cmydlarz/sonyc-mk1-microphone/microphone-board/images/back_front.jpg

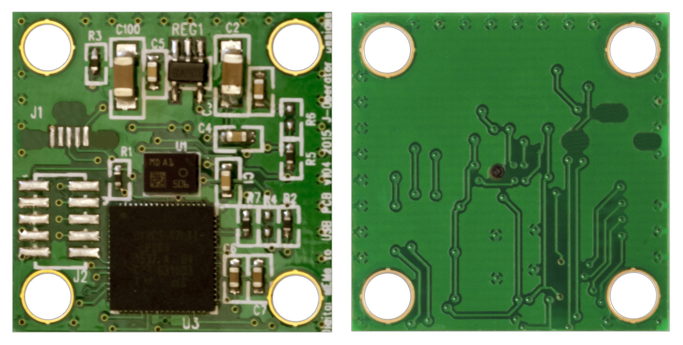
microphone-board/images/back_front.jpg
