cmydlarz/sonyc-mk1-microphone/microphone-board/images/MP34DB01.png

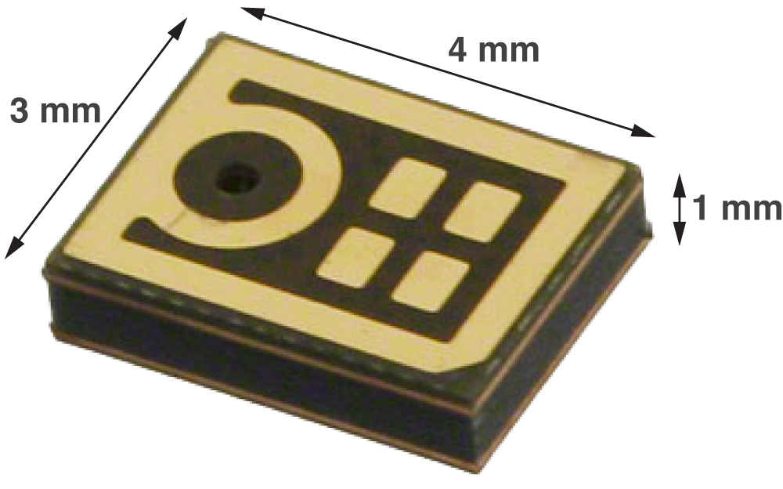
microphone-board/images/MP34DB01.png
