cmydlarz/sonyc-mk1-microphone/microphone-board/images/psoc5_board_scan.png

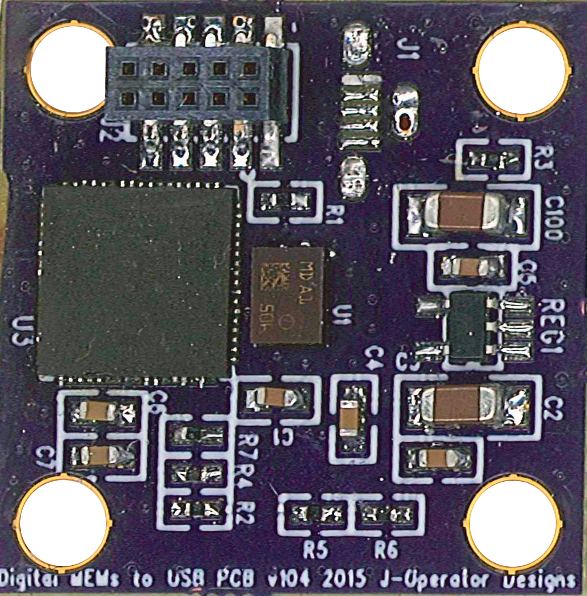
microphone-board/images/psoc5_board_scan.png
