cmydlarz/sonyc-mk1-microphone/microphone-board/images/top-layer.jpg

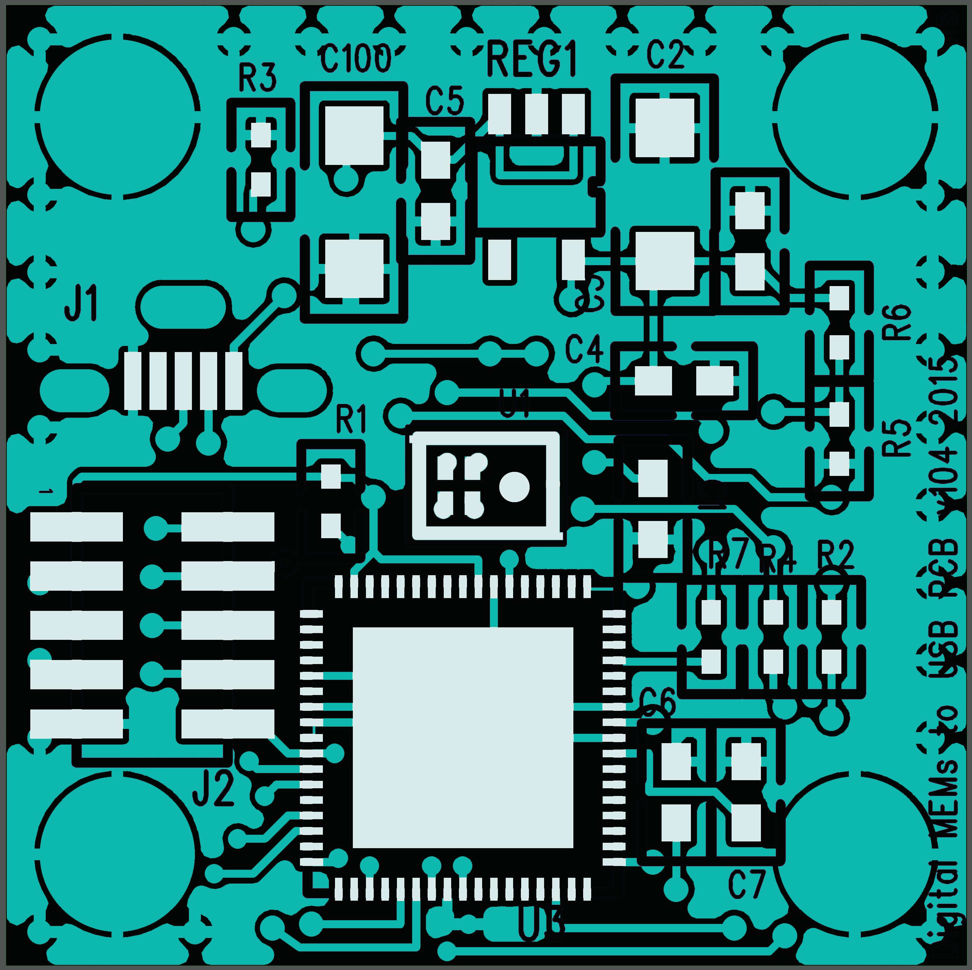
microphone-board/images/top-layer.jpg
