cmydlarz/sonyc-mk1-microphone/microphone-cal/cal-mount_2021-Aug-09_09-26-31PM-000_CustomizedView19559447086.png

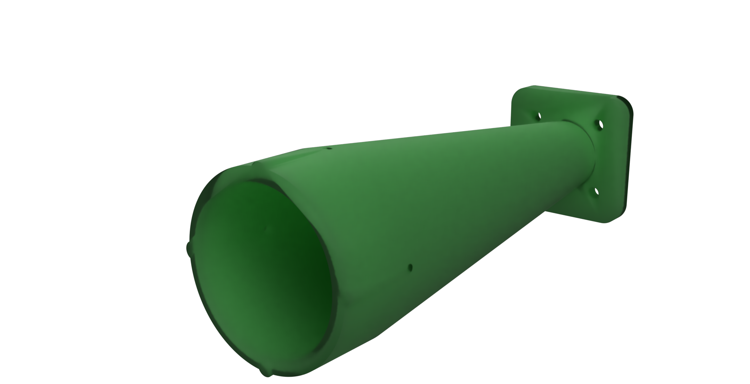
microphone-cal/cal-mount_2021-Aug-09_09-26-31PM-000_CustomizedView19559447086.png
