cmydlarz/sonyc-mk1-microphone/microphone-mount/mic_mount_v2-simple_small_shifted.png

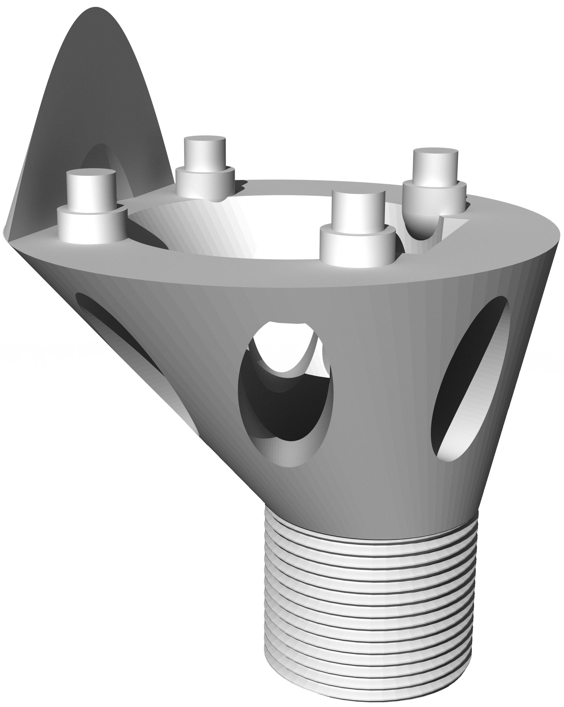
microphone-mount/mic_mount_v2-simple_small_shifted.png
