cmydlarz/sonyc-mk1-microphone/microphone-board/digital-MEMs-USB-v105.pdf

6 | 5 | 4 | 3 | 2 | 1

D

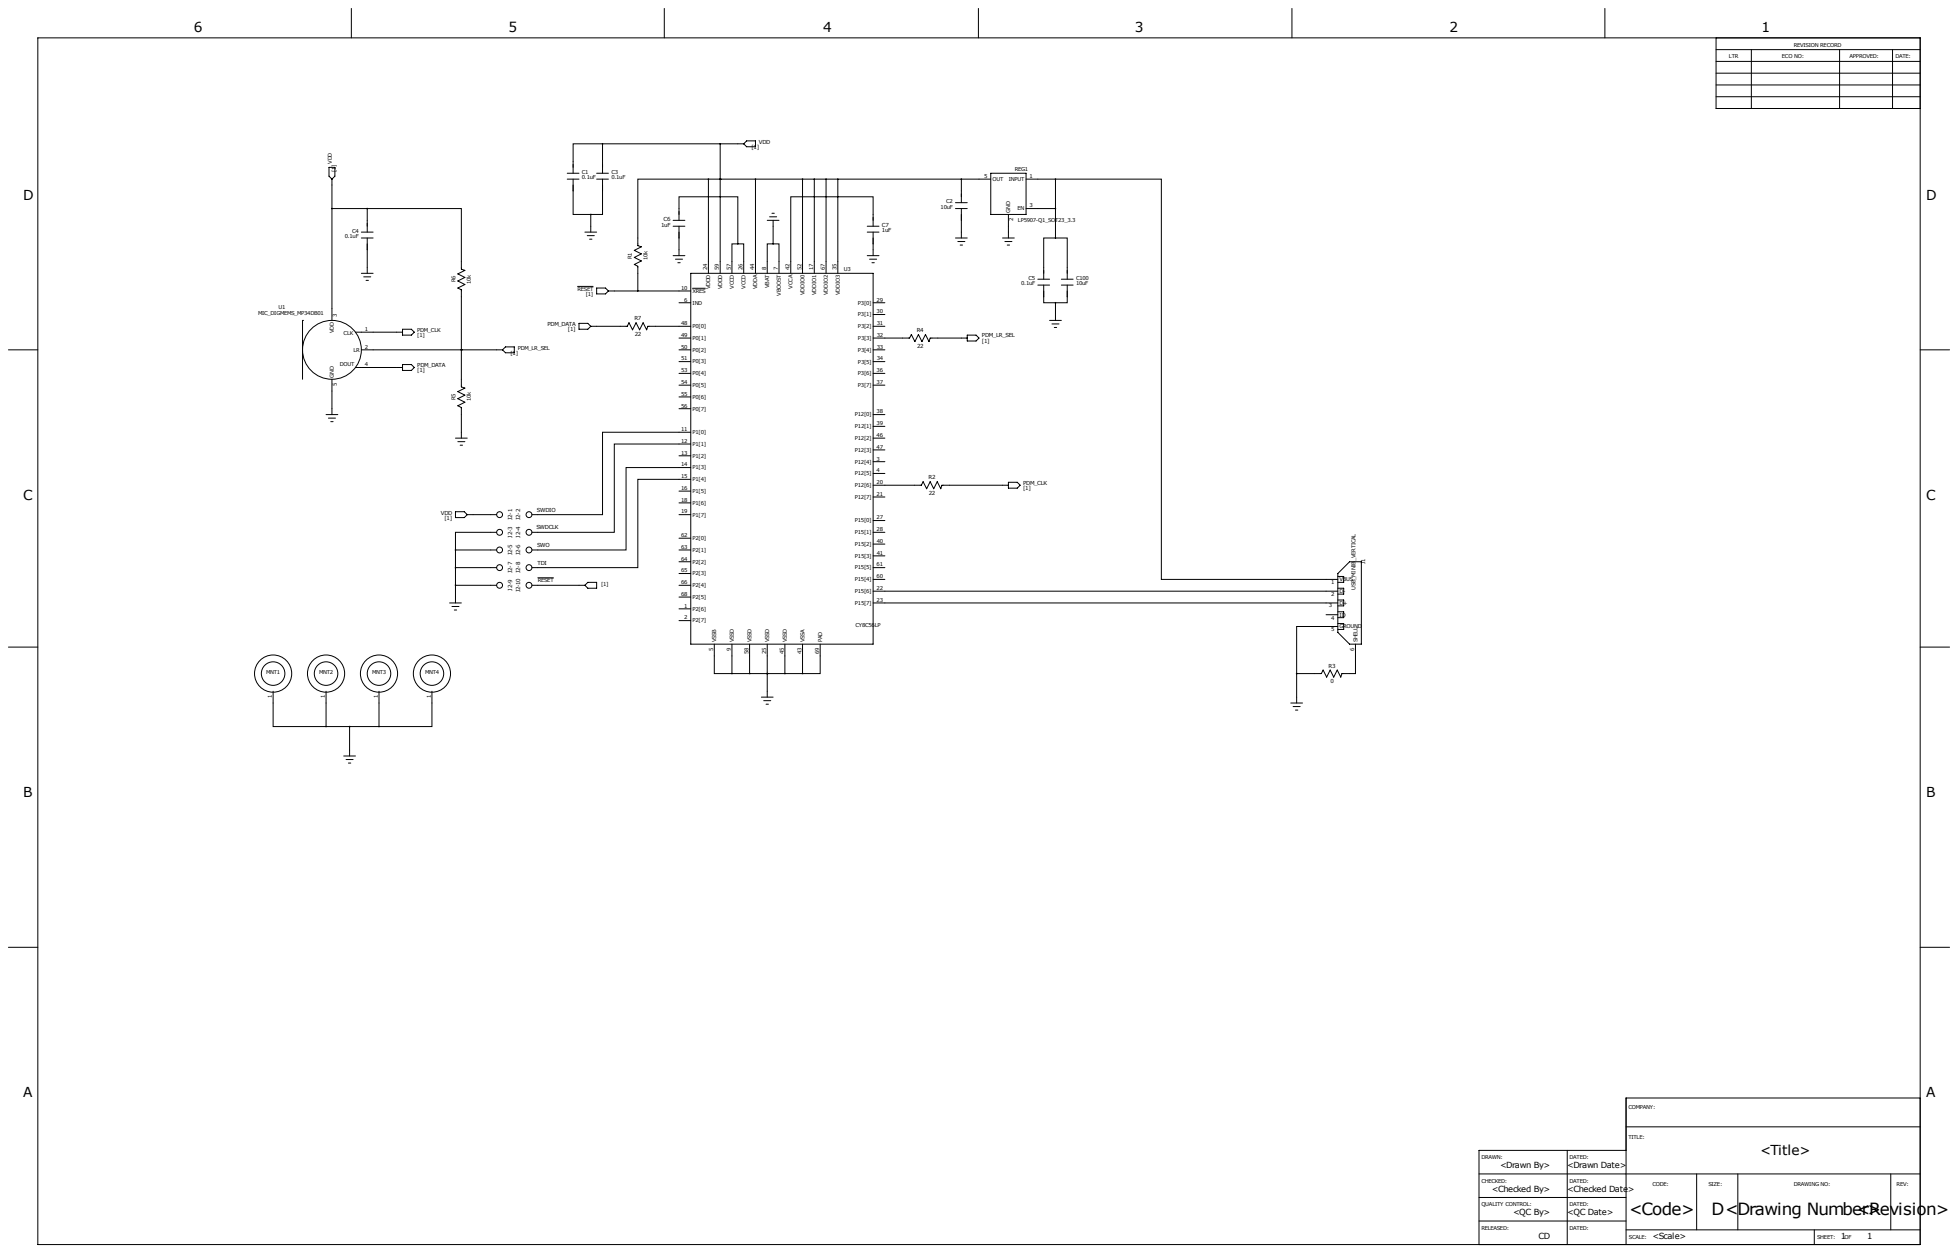
[picture p12: page 1]

VDD | REVISION RECORD

LTR | ECO NO: | APPROVED: | DATE:

DRAWN: <Drawn By> | DATED: <Drawn Date>

CHECKED: <Checked By> | DATED: <Checked Date> | CODE: <Code> | SIZE: D<Drawing Number> | DRAWING NO: | REV:

QUALITY CONTROL: <QC By> | <QC Date> DATED:

RELEASED: CD | DATED:

SCALE: <Scale> | SHEET: 1 OF 1
