cmydlarz/sonyc-mk1-microphone/microphone-board/pcb_dims.pdf

ø3.5

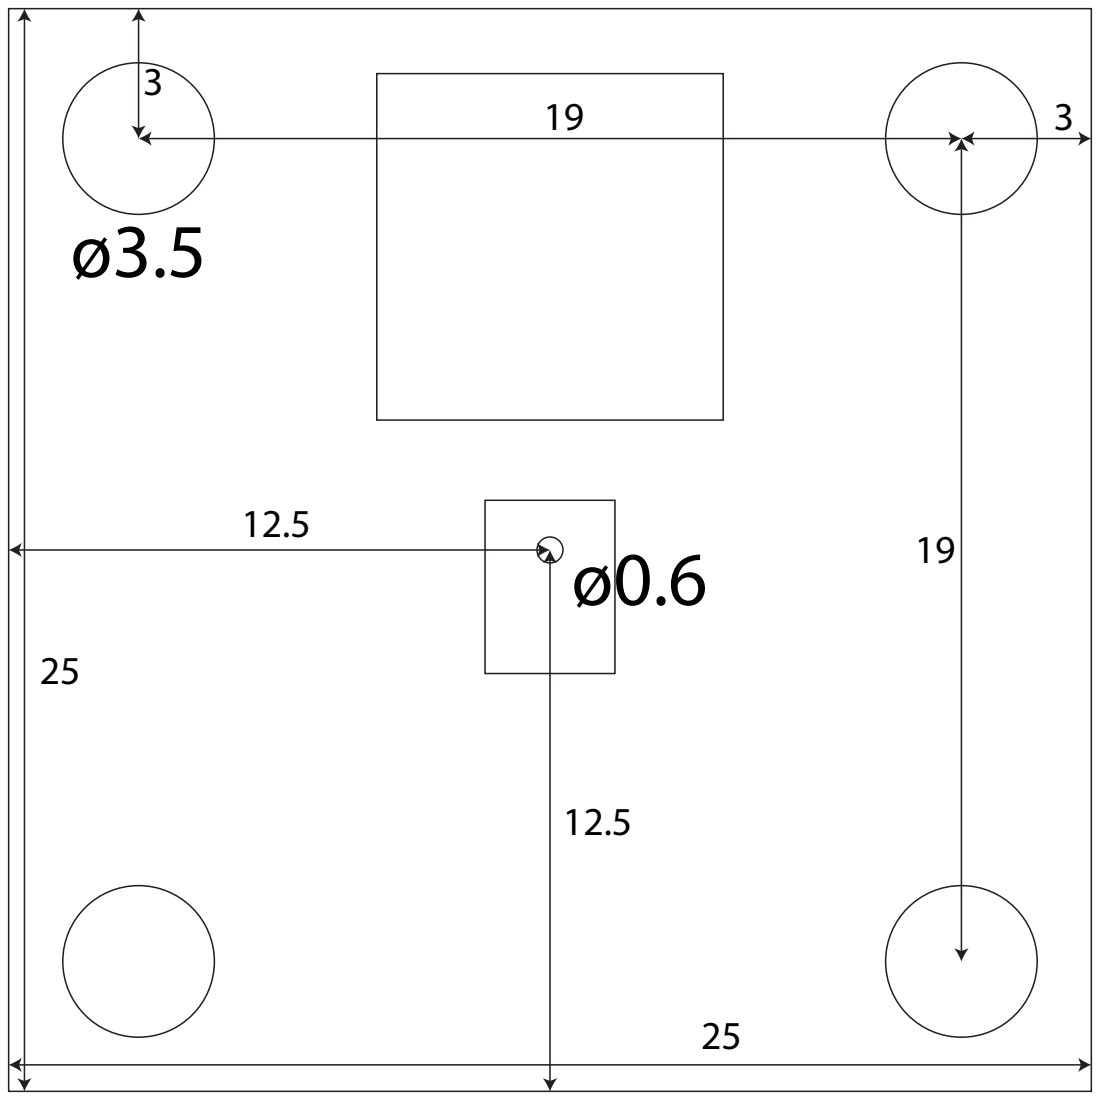
[picture p13: page 1]
