cmydlarz/sonyc-mk1-microphone/microphone-firmware/psoc5LP_firmware/PioneerKit_P5LP_USB_Audio/PioneerKit_P5LP_USB_Audio.cydsn/codegentemp/Droop_Filter_Coefficients.c

#include "Droop_Filter.h"
#include "Droop_Filter_PVT.h"


/*******************************************************************************
* ChannelA filter coefficients.
* Filter Type is: Biquad
*******************************************************************************/

/* Number of Biquad sections are: 23 */

uint8 ChannelABiquadCoefficients[] = 
{
 /* Coefficients of Section 0 */
 0xF0, 0xFF, 0x0F, 0x00, /* Section(0)_A0, 0.249996185302734 */

 0x26, 0x7F, 0x19, 0x00, /* Section(0)_A1, 0.398385524749756 */

 0x8C, 0xCE, 0x0E, 0x00, /* Section(0)_A2, 0.231356620788574 */

 0x1A, 0x03, 0x9A, 0x00, /* Section(0)_B1, 1.59356069564819 */

 0xA3, 0xC5, 0xC4, 0x00, /* Section(0)_B2, 0.925437211990356 */

 /* Coefficients of Section 1 */
 0x13, 0x00, 0x40, 0x00, /* Section(1)_A0, 1.000004529953 */

 0x53, 0x9A, 0x6C, 0x00, /* Section(1)_A1, 1.69691920280457 */

 0xC8, 0xBE, 0x3D, 0x00, /* Section(1)_A2, 0.96476936340332 */

 0xCC, 0x65, 0x93, 0x00, /* Section(1)_B1, 1.69691181182861 */

 0x4D, 0x41, 0xC2, 0x00, /* Section(1)_B2, 0.964764356613159 */

 /* Coefficients of Section 2 */
 0x8A, 0xFF, 0x3F, 0x00, /* Section(2)_A0, 0.999971866607666 */

 0x69, 0x85, 0x5B, 0x00, /* Section(2)_A1, 1.43001770973206 */

 0x57, 0x9E, 0x3A, 0x00, /* Section(2)_A2, 0.915914297103882 */

 0xE8, 0x79, 0xA4, 0x00, /* Section(2)_B1, 1.4300594329834 */

 0x33, 0x61, 0xC5, 0x00, /* Section(2)_B2, 0.915942430496216 */

 /* Coefficients of Section 3 */
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

 0x84, 0x99, 0xD0, 0x00, /* Section(22)_B2, 0.740630149841309 */
};


/*******************************************************************************
* ChannelB filter coefficients.
* Filter Type is FIR
*******************************************************************************/

/* Number of FIR filter taps are: 2 */

uint8 ChannelBFirCoefficients[] = 
{
 0xAC, 0xFF, 0x7F, 0x00, /* Tap(0), 0.999989986419678 */

 0x00, 0x00, 0x00, 0x00, /* Tap(1), 0 */
};
