cmydlarz/sonyc-mk1-microphone/microphone-firmware/psoc5LP_firmware/PioneerKit_P5LP_USB_Audio/PioneerKit_P5LP_USB_Audio.cydsn/codegentemp/Droop_Filter_RAM_Data.c

#include "Droop_Filter.h"
#include "Droop_Filter_PVT.h"

const uint8 CYCODE Droop_Filter_control[] = 
{
    0x20, 0x13, 0x00, 0x25, 0x61, 0x17, 0x80, 0x26,
    0x01, 0x00, 0x80, 0x26, 0x01, 0x00, 0x80, 0x26,
    0x01, 0x00, 0x80, 0x26, 0x20, 0x13, 0x80, 0x26,
    0xC2, 0x0C, 0x80, 0x26, 0xE0, 0x0E, 0x80, 0x26,
    0xA4, 0x0A, 0x80, 0x26, 0x63, 0x17, 0x10, 0x06,
    0x8C, 0x08, 0x80, 0x26, 0x6E, 0x06, 0x80, 0x6D,
    0x6C, 0x06, 0x80, 0x2F, 0x20, 0x02, 0x10, 0x6F,
    0x00, 0x80, 0x80, 0x26, 0x20, 0x02, 0x80, 0x6F,
    0x00, 0x80, 0x80, 0x26, 0x20, 0x02, 0x80, 0x6F,
    0x20, 0x02, 0x80, 0x6F, 0x21, 0x1A, 0x40, 0xFE,
    0x00, 0x00, 0x87, 0x26, 0x02, 0x22, 0x10, 0x66,
    0x00, 0x80, 0x10, 0x6E, 0x01, 0x82, 0x80, 0x26,
    0xE6, 0x0E, 0x80, 0x26, 0xC8, 0x0C, 0x80, 0x26,
    0x00, 0x00, 0x80, 0x06, 0x6B, 0x87, 0x18, 0x6D,
    0x6A, 0x09, 0x18, 0x3E, 0x00, 0x00, 0x80, 0x26,
    0x01, 0x20, 0x80, 0x26, 0x21, 0x02, 0x18, 0x7F,
    0x00, 0x00, 0x00, 0x00, 0x00, 0x00, 0x00, 0x00,
    0x00, 0x00, 0x00, 0x00, 0x00, 0x00, 0x00, 0x00,
    0x00, 0x00, 0x00, 0x00, 0x00, 0x00, 0x00, 0x00,
    0x00, 0x00, 0x00, 0x00, 0x00, 0x00, 0x00, 0x00,
    0x00, 0x00, 0x00, 0x00, 0x00, 0x00, 0x00, 0x00,
    0x00, 0x00, 0x00, 0x00, 0x00, 0x00, 0x00, 0x00,
    0x00, 0x00, 0x00, 0x00, 0x00, 0x00, 0x00, 0x00,
    0x00, 0x00, 0x00, 0x00, 0x00, 0x00, 0x00, 0x00,
    0x00, 0x00, 0x00, 0x00, 0x00, 0x00, 0x00, 0x00,
    0x00, 0x00, 0x00, 0x00, 0x00, 0x00, 0x00, 0x00,
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
    0x00, 0x00, 0x00, 0x00, 0x00, 0x00, 0x00, 0x00,
    0x00, 0x00, 0x00, 0x00, 0x00, 0x00, 0x00, 0x00,
    0x00, 0x00, 0x00, 0x00, 0x00, 0x00, 0x00, 0x00,
    0x00, 0x00, 0x00, 0x00, 0x00, 0x00, 0x00, 0x00,
    0x00, 0x00, 0x00, 0x00, 0x00, 0x00, 0x00, 0x00,
   };
